CapnKernel/panoboard2/edges2.FCStd

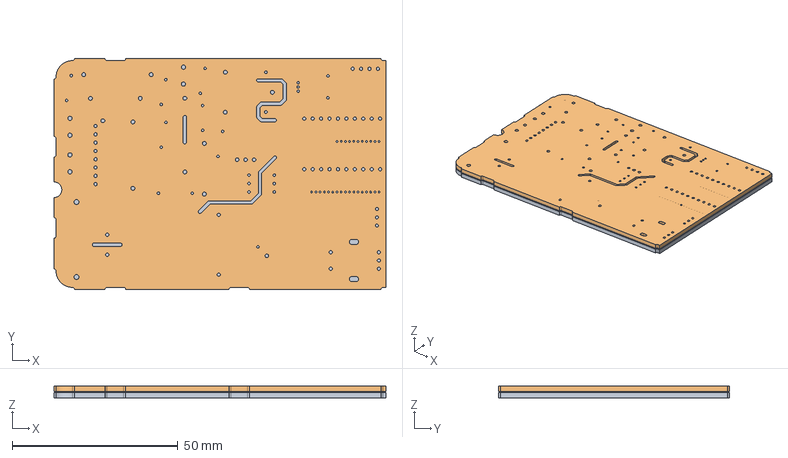
[picture p1: CAD file, 2024-07-11]
edges2.FCStd
100.0 x 69.5 x 3.60 mm
Pcb_651
