CapnKernel/panoboard2/panoboard2.kicad_pcb

## KiCad design panoboard2.kicad_pcb (2026-01-21)

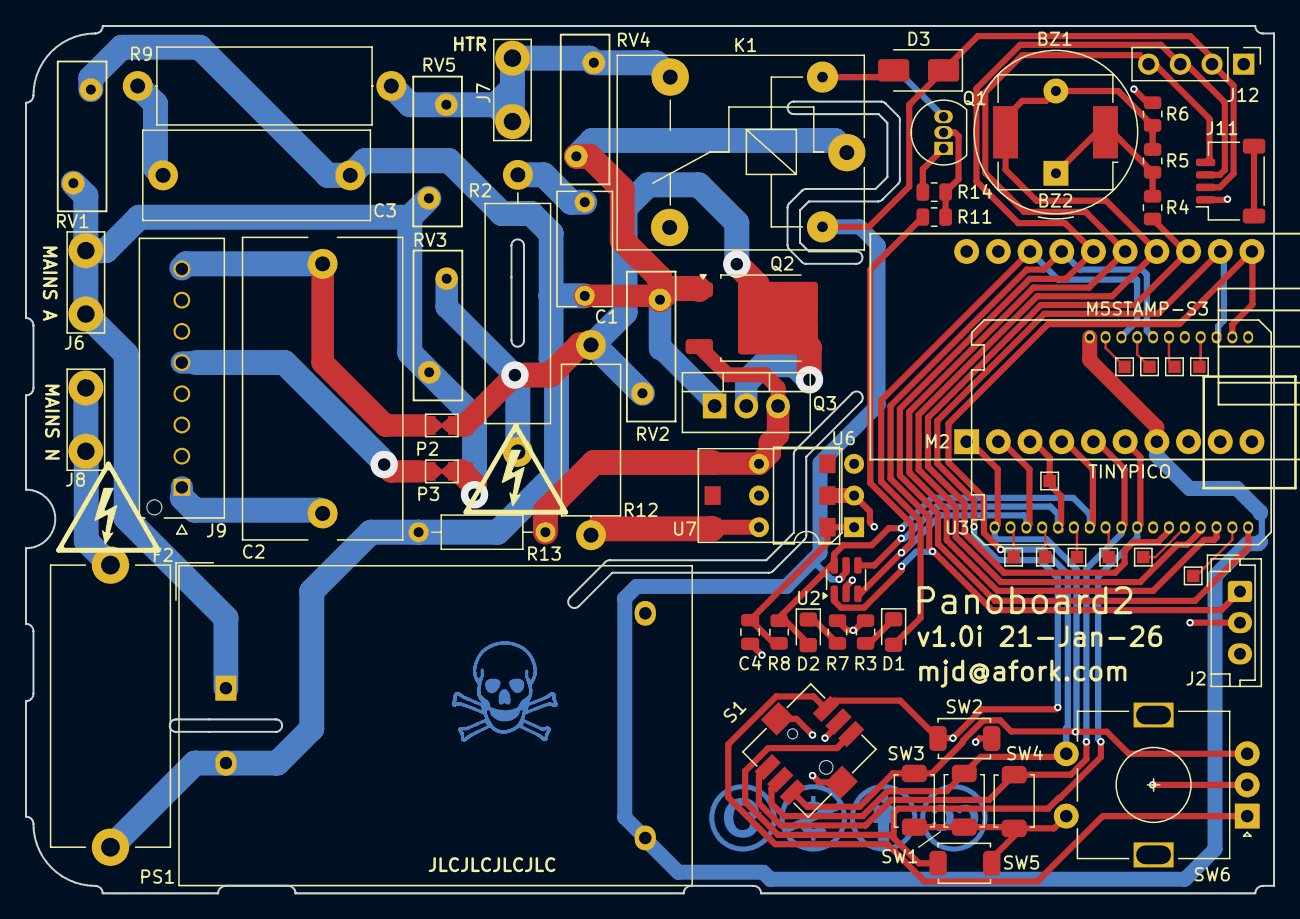
[picture p2: board panoboard2.kicad_pcb from above]

Board: 2 copper layers, 100.0 x 69.5 mm, 64 parts (0 on the bottom side), 44 nets.

Parts:
BZ1: Buzzer; Buzzer_D12mm_H8.1mm
BZ2: FUET9018; Buzzer_CUI_CPT-9019S-SMT
C1: 100n 250V; C_Rect_L9.0mm_W4.2mm_P7.50mm_MKT
C2: 3uF 430VAC; C_Rect_L24.0mm_W12.6mm_P20.00mm_MKT
C3: 10n 1000V; C_Rect_L18.0mm_W7.0mm_P15.00mm_FKS3_FKP3
C4: 10n; C_0805_2012Metric
D1, D2: R LED; LED_0805_2012Metric_Pad1.15x1.40mm_HandSolder
D3: SS34; D_SMA
F2: 5A; Fuseholder_Cylinder-5x20mm_Stelvio-Kontek_PTF78_Horizontal_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
J2: THERMISTOR; JST_EH_B3B-EH-A_1x03_P2.50mm_Vertical
J6: BLK/MAINS L; TE-1742361-1-QC-Tab
J7: WHT/HTR; TE-1742361-1-QC-Tab
J8: ORA/MAINS N; TE-1742361-1-QC-Tab
J9: MOLEX 53375-0810; MOLEX_533750810
J11: I2C1; JST_SH_SM04B-SRSS-TB_1x04-1MP_P1.00mm_Horizontal
J12: I2C2; PinHeader_1x04_P2.54mm_Vertical
JP1, JP22, JP23, JP24, JP25, JP29, JP30, JP31, JP32, JP33, JP34: PCB_Pin_Breakout; TestPoint_Pad_1.0x1.0mm
K1: Relay_SPDT; Relay_SPDT_SANYOU_SRD_Series_Form_C
M2: TINYPICO
P2, P3: PCB_Patch; SolderJumper-2_P1.3mm_Bridged_Pad1.0x1.5mm
PS1: HLK-5M03; Converter_ACDC_Hi-Link_HLK-5Mxx
Q1: 2N7000; TO-92_Inline
Q2: BT136S-600; TO-252-2
Q3: BT136-600; TO-220-3_Vertical
R2: 22R 2W; R_Axial_DIN0516_L15.5mm_D5.0mm_P22.2mm_Horizontal
R3: R; R_0805_2012Metric
R4, R5: 1k; R_0805_2012Metric
R6: 100k; R_0805_2012Metric
R7: R so I=5mA; R_0805_2012Metric
R8: R so I=10mA; R_0805_2012Metric
R9: 39R 2W; R_Axial_DIN0617_L17.0mm_D6.0mm_P20.32mm_Horizontal
R11: 220R; R_0805_2012Metric
R12: 360R 1W; R_Axial_DIN0414_L11.9mm_D4.5mm_P15.24mm_Horizontal
R13: 360R; R_Axial_DIN0207_L6.3mm_D2.5mm_P10.16mm_Horizontal
R14: 10k; R_0805_2012Metric
RV1, RV2, RV3, RV4, RV5: 10D271K; RV_Disc_D12mm_W3.9mm_P7.5mm
S1: SKRHABE010
SW1, SW2, SW3, SW4, SW5: SW_Push; SW_Push_SPST_NO_432
SW6: RotaryEncoder_Switch_MP; RotaryEncoder_Alps_EC11E-Switch_Vertical_H20mm
U2: SRV05-4; SOT-23-6
U3: M5STAMP-S3; STAMP-S3-DIP_copy
U6: MOC3063; DIP-6_W7.62mm
U7: MOC3063S; SOIC-6

Connections:
+3V3: D3.1 (K), J11.2, J12.2, K1.A1, M2.7 (V3.3), PS1.4 (+Vout), U2.5 (VP), U3.28 (3V3)
/BUZZ1: M2.13 (18), R4.2, U3.12 (A2CH0/TCH11/GPIO11)
/BUZZ2: BZ1.2 (-), BZ2.2 (-), M2.14 (5), R5.1, R6.2, U3.14 (A2CH1/TCH12/GPIO12)
/DS18B20: JP1.1, M2.3 (27), U2.4 (IO3), U3.5 (A1CH4/TCH5/GPIO5)
/HEATER: M2.2 (26), R11.1, U2.3 (IO2), U3.3 (A1CH2/TCH3/GPIO3)
/HTR_N: J7.1, K1.14, R9.1, RV4.2, RV5.2
/LED: D1.2 (A), M2.18 (33), U3.26 (GPIO43/CLK1/TXD)
/MOTOR: D2.2 (A), M2.4 (15), R8.1, U2.6 (IO4), U3.7 (A1CH6/TCH7/GPIO7)
/MTR_N: P2.1, Q2.2 (A2), Q3.2 (A2), R2.2, R12.1, RV2.2, RV3.2
/SCL: J11.4, J12.4, M2.15 (22), U3.15 (A2CH2/TCH13/GPIO13/SDA)
/SDA: J11.3, J12.3, M2.16 (21), U3.17 (A2CH4/TCH1/GPIO15/SCL)
/SW1: M2.11 (23), S1.2, SW1.1, SW6.S1, U3.19 (GPIO39/CLK3/MTCK)
/SW2: M2.12 (19), S1.4, SW2.2, SW6.A, U3.20 (GPIO0)
/SW3: M2.1 (25), S1.3, SW3.1, SW6.B, U3.1 (A1CH0/TCH1/GPIO1)
/SW4: M2.5 (14), S1.1, SW4.2, U3.9 (A1CH8/TCH9/GPIO9)
/SW5: M2.6 (4), S1.6, SW5.2, U3.10 (A1CH9/TCH10/GPIO10)
/THERM: J2.1, M2.17 (32), U2.1 (IO1), U3.24 (GPIO44/CLK2/RXD)
GND: C4.2, J2.2, J2.3, J11.1, J12.1, M2.9 (GND), PS1.3 (-Vout), Q1.1 (S), R3.2, R6.1, R7.1, R14.1, S1.5, S1.SH1, S1.SH2, SW1.2, SW2.1, SW3.2, SW4.1, SW5.1, SW6.C, SW6.MP, SW6.S2, U2.2 (VN), U3.11 (GND), U3.18 (GND), U6.2, U7.2
MAINS_A: J6.1, P3.1, PS1.1 (AC/L), RV1.1, RV3.1, RV5.1
MAINS_N: C1.1, C3.2, F2.2, K1.11, PS1.2 (AC/N), Q2.1 (A1), Q3.1 (A1), R13.2, RV1.2, RV2.1, RV4.1
unnamed: BZ1.1 (+), BZ2.1 (+), R4.1, R5.2
unnamed: C1.2, R2.1
unnamed: C3.1, R9.2
unnamed: C4.1, R8.2, U6.1, U7.1
unnamed: D1.1 (K), R3.1
unnamed: D2.1 (K), R7.2
unnamed: D3.2 (A), K1.A2, Q1.3 (D)
unnamed: F2.1, J8.1
unnamed: C2.1, J9.1
unnamed: J9.5, P3.2
unnamed: C2.2, J9.8, P2.2
unnamed: Q1.2 (G), R11.2, R14.2
unnamed: Q2.3 (G), Q3.3 (G), R13.1, U6.4, U7.4
unnamed: R12.2, U6.6, U7.6
unnamed: JP30.1, U3.13 (5V)
unnamed: JP22.1, U3.2 (A1CH1/TCH2/GPIO2)
unnamed: JP23.1, U3.4 (A1CH3/TCH4/GPIO4)
unnamed: JP24.1, U3.6 (A1CH5/TCH6/GPIO6)
unnamed: JP25.1, U3.8 (A1CH7/TCH8/GPIO8)
unnamed: JP29.1, U3.16 (A2CH3/TCH14/GPIO14)
unnamed: JP34.1, U3.21 (GPIO40/CLK2/MTD0)
unnamed: JP33.1, U3.23 (GPIO41/CLK1/MTDI)
unnamed: JP32.1, U3.25 (GPIO42/MTMS)
unnamed: JP31.1, U3.27 (GPIO46)
