CapnKernel/panoboard2/(commit log)

2024-05-31 First revision
    [ac-switcher.kicad_sch, panoboard2.kicad_pcb, panoboard2.kicad_sch]
2024-06-19 More mods
    [ac-switcher.kicad_sch, panoboard2.kicad_sch]
2024-07-10 Revision 1.0c, after fit tests
    [ac-switcher.kicad_sch, panoboard2.kicad_pcb, panoboard2.kicad_sch]
2024-07-10 Many improvements
    Moved fuse to the neutral line so heater is protected
    Added slot under R2
    Moved mounting hole
    Improved board outline
    Added OSHW licence and KiCad shout-out
    Fixed buzzer pin pitch
    [edges2.FCStd, panoboard2.kicad_pcb, panoboard2.kicad_sch]
2024-07-11 Removed a rebate because there's a support under it.
    [edges2.FCStd, panoboard2.kicad_pcb]
2024-07-11 Moved soldermask no-mans-land to match new slots.
    [panoboard2.kicad_pcb]
2024-07-11 Added JLC production code placement cue
    [panoboard2.kicad_pcb]
2024-07-13 Rotated incorrectly placed motor connector, and added many 3D models.
    [panoboard2.kicad_pcb, panoboard2.kicad_sch]
2026-01-21 Added LCSC part number for 2N7000
    [panoboard2.kicad_sch]
2026-01-21 Saved with KiCad 9
    [panoboard2.kicad_pcb, panoboard2.kicad_sch]
2026-01-21 Added footprint in use but not yet committed.
2026-01-21 Fixed location and size of fuse 3d model
    [panoboard2.kicad_pcb]
2026-01-21 Bumped version number
    [panoboard2.kicad_pcb]
2026-01-21 Ignore gerber and drill files
