CapnKernel/panoboard2/(notices)

Notices in the files:
panoboard2.kicad_pcb:
CC BY-NC-SA 4.0
